professional-yoghurt-eater/People-following-robot/Final_pic_2.jpg

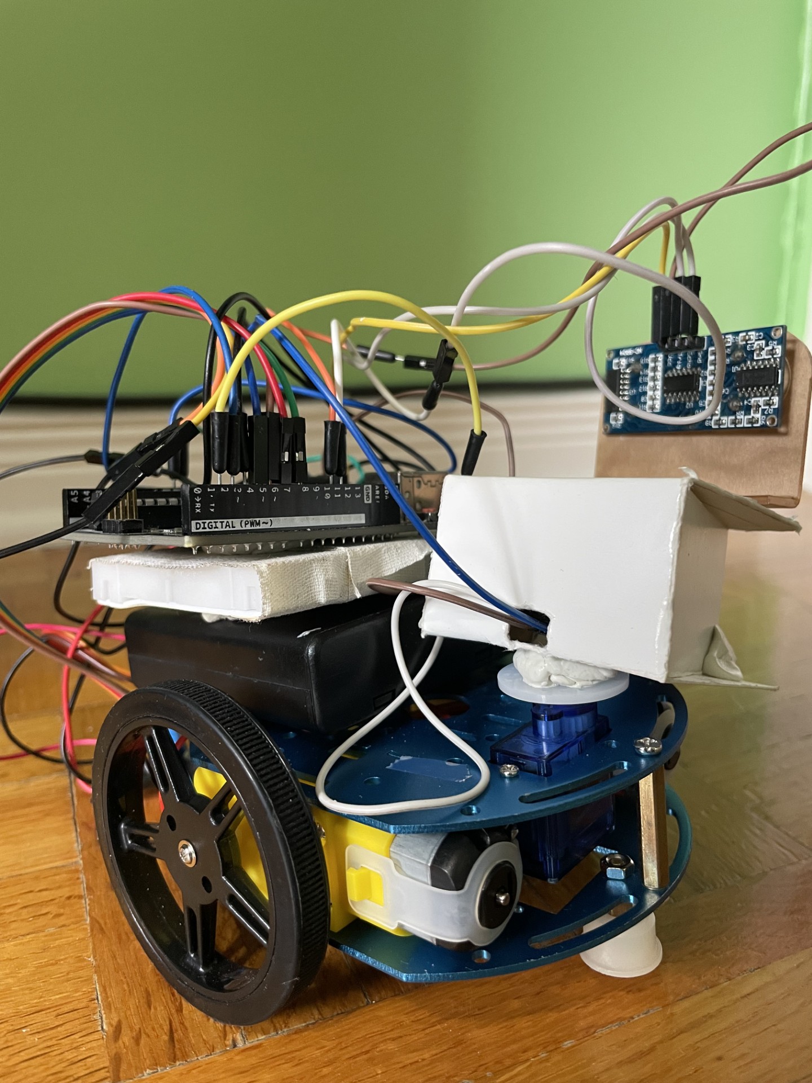
Final_pic_2.jpg
