professional-yoghurt-eater/People-following-robot/Final_pic_3.jpg

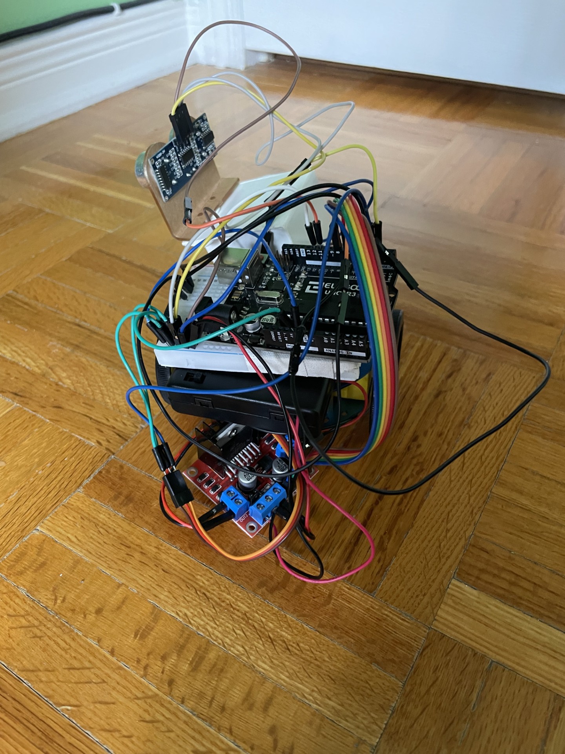
Final_pic_3.jpg
