professional-yoghurt-eater/People-following-robot/CE_schematic.png

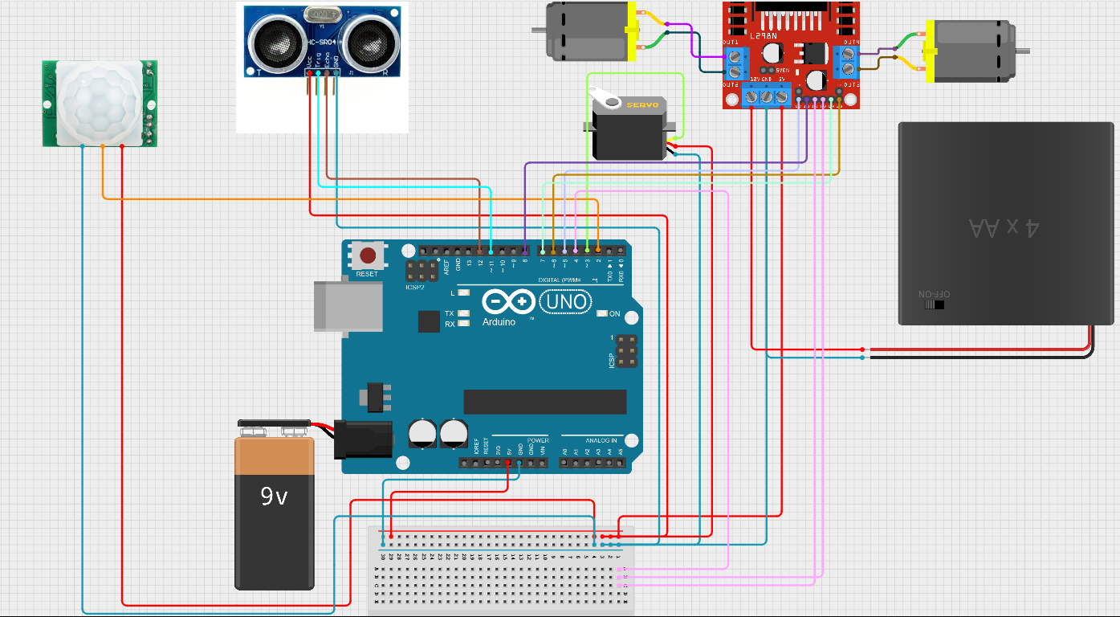
CE_schematic.png
