professional-yoghurt-eater/People-following-robot/Final_pic_1.jpg

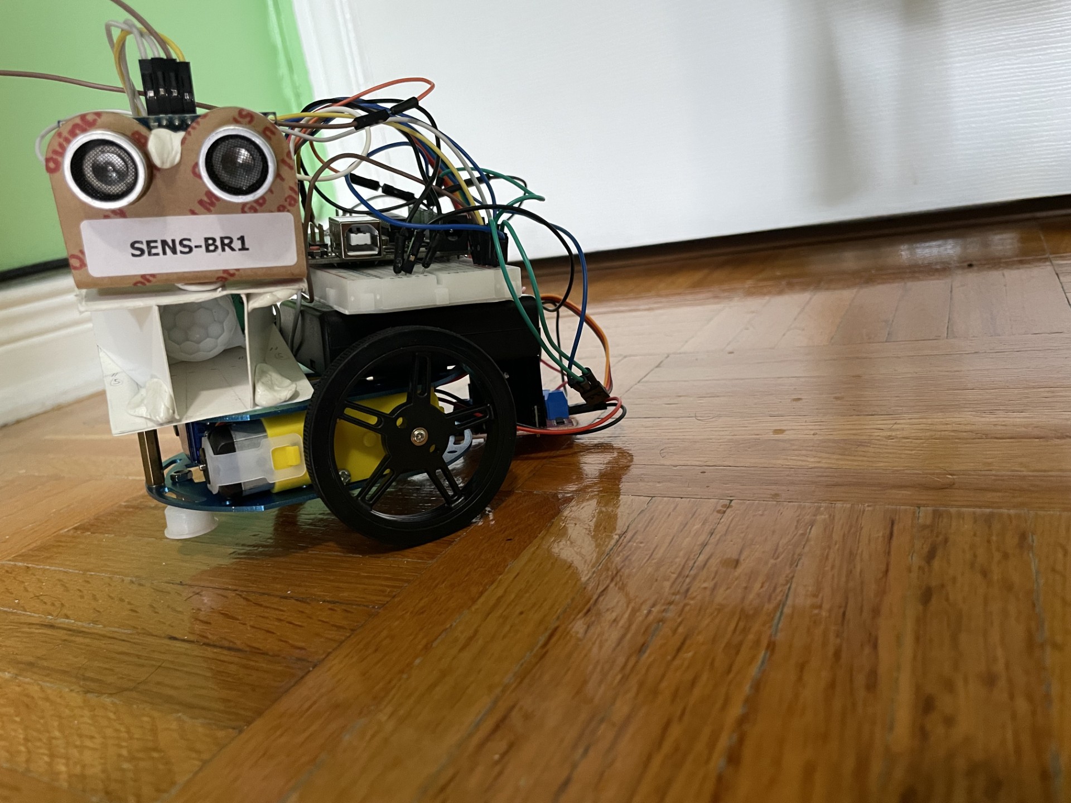
Final_pic_1.jpg
