professional-yoghurt-eater/People-following-robot/Final_pic_4.jpg

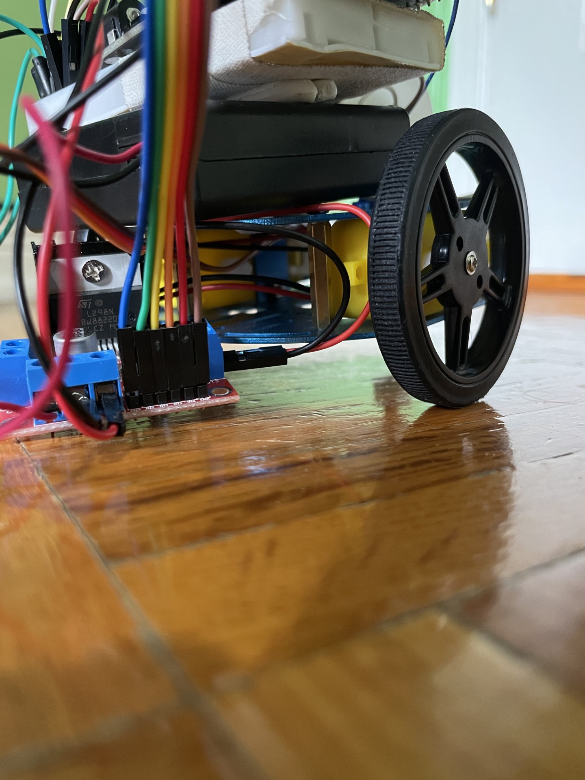
Final_pic_4.jpg
